PS-TITANS-G5/Balloone/mecanica/README.md

# Mecânica

CAD exportado (STEP, STL), desenhos e imagens. Junto do CAD, coloque o link do projeto original.
