PS-TITANS-G5/Balloone/docs/README.md

# Docs

O que envolve o robô todo. As decisões ficam no Notion do grupo.

- `requisitos.md`: o que o edital exige do robô.
- `arquitetura.md`: as partes do robô e como elas se ligam.
- `rede/`: como o notebook do piloto conversa com o robô.
- `fluxos-funcionamento.pdf` e `rede/estudo.pdf`: documentos do PC1. Mostram o que se sabia em 31/10; o que mudou depois está em `rede/README.md`.
