PS-TITANS-G5/Balloone/eletronica/README.md

# Eletrônica

Esquemáticos, placa e lista de componentes.
