PS-TITANS-G5/Balloone/eletronica/esquematico-eletronica.pdf

### GND

### GND

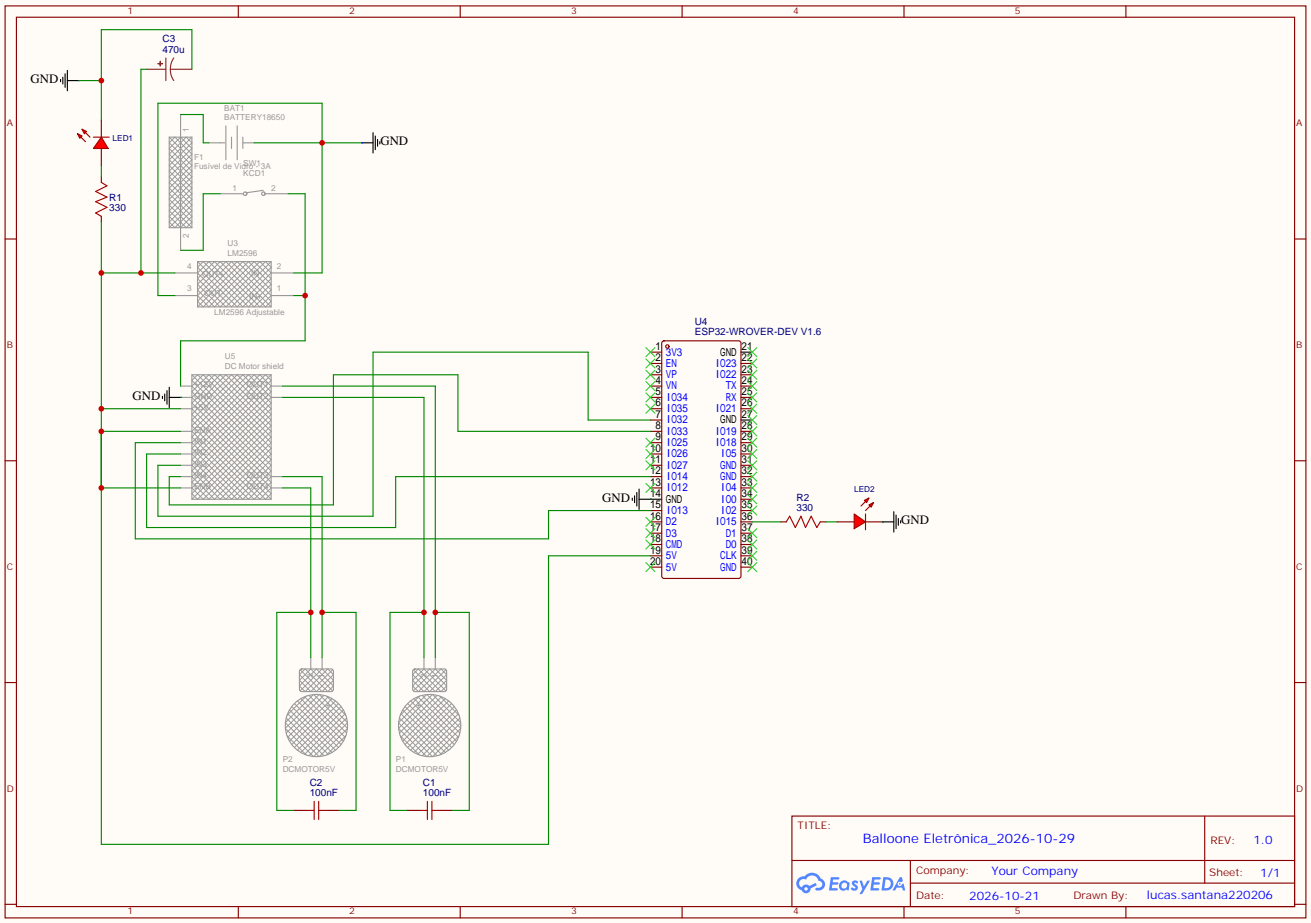
[picture p2: page 1]
