PS-TITANS-G5/Balloone/(commit log)

2026-11-03 feat(redes): adiciona prototipo Wi-Fi PC2
    [registro_testes.csv]
2026-11-03 docs: atualizar organização do repositório
    [registro_testes.csv]
2026-11-04 docs: organiza arquivos e padroniza nomes
    [registro-testes.csv]
2026-11-05 firmware: corrige a pinagem da câmera para a Freenove
    [balloone.ino]
2026-11-05 docs: atualiza e enxuga os documentos de rede e do firmware
2026-11-10 docs: adiciona o diagrama de blocos
